Pyk33/od-11-minimix/scratch/u7_crop.png

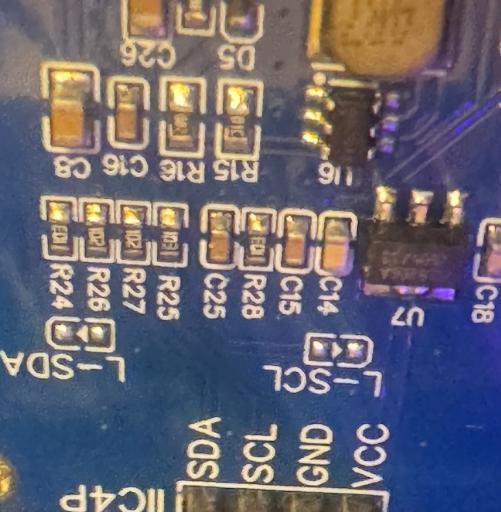
scratch/u7_crop.png
