Pyk33/od-11-minimix/scratch/oled_board_crop.png

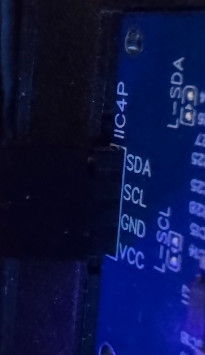
scratch/oled_board_crop.png
