Pyk33/od-11-minimix/scratch/all_columns_top.png

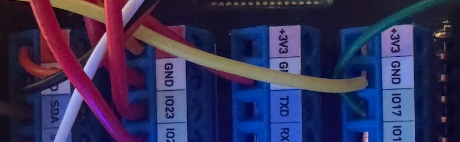
scratch/all_columns_top.png
