Pyk33/od-11-minimix/scratch/gpio_leds_hi.png

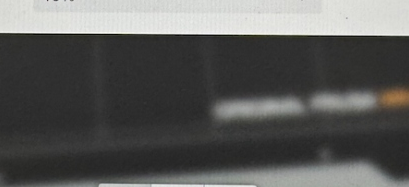
scratch/gpio_leds_hi.png
