Pyk33/od-11-minimix/scratch/mc01506_pdf.png

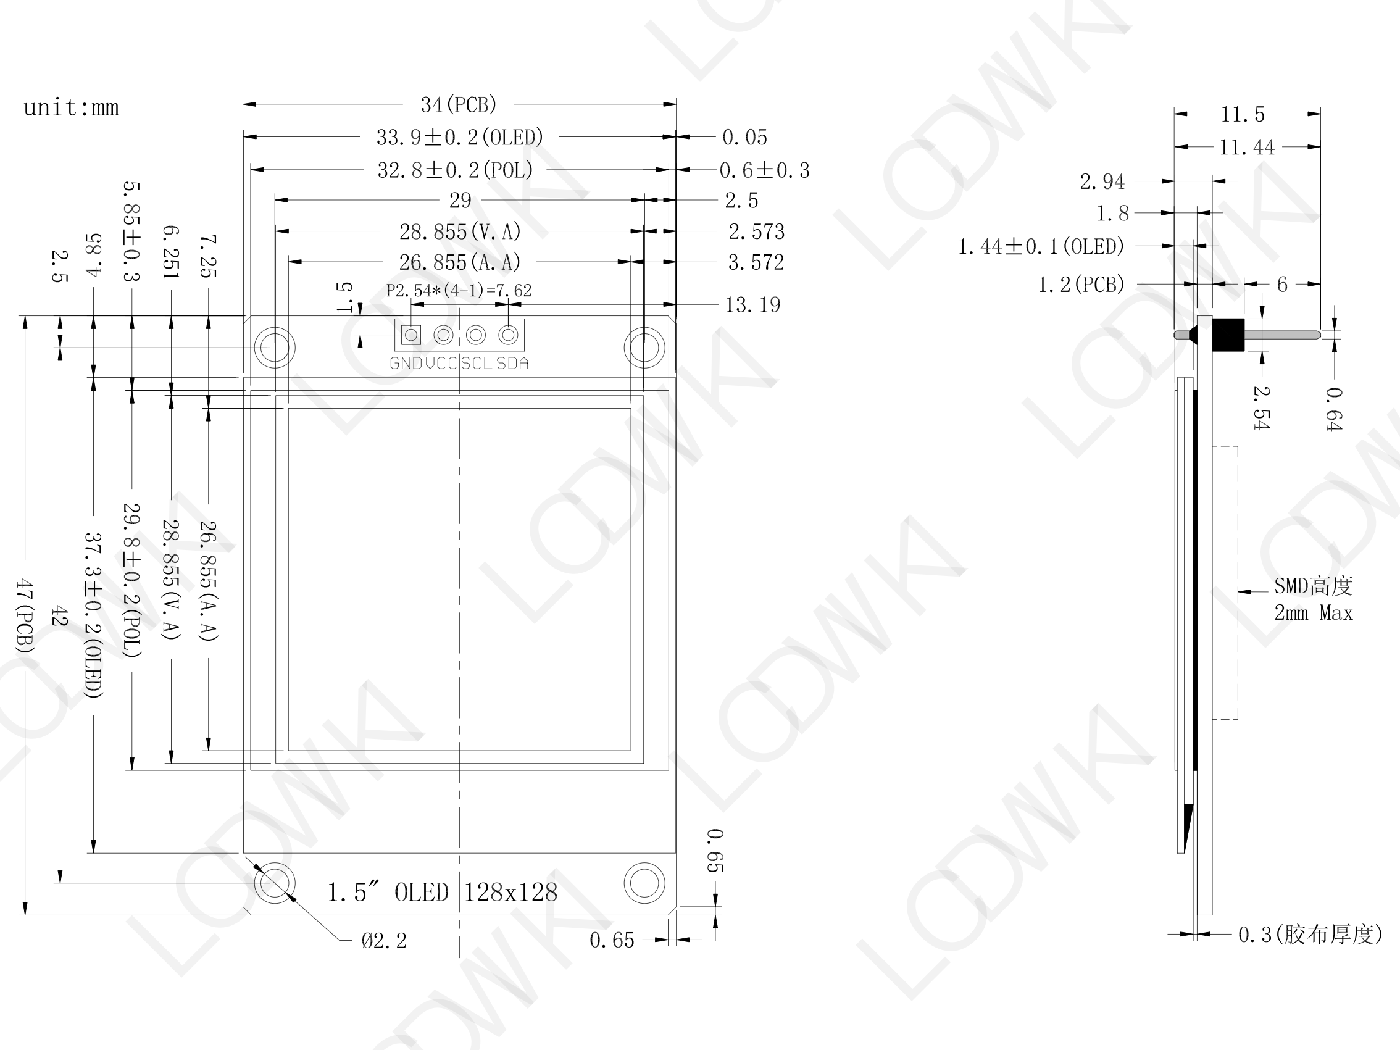
scratch/mc01506_pdf.png
