Pyk33/od-11-minimix/scratch/mc01506_size.png

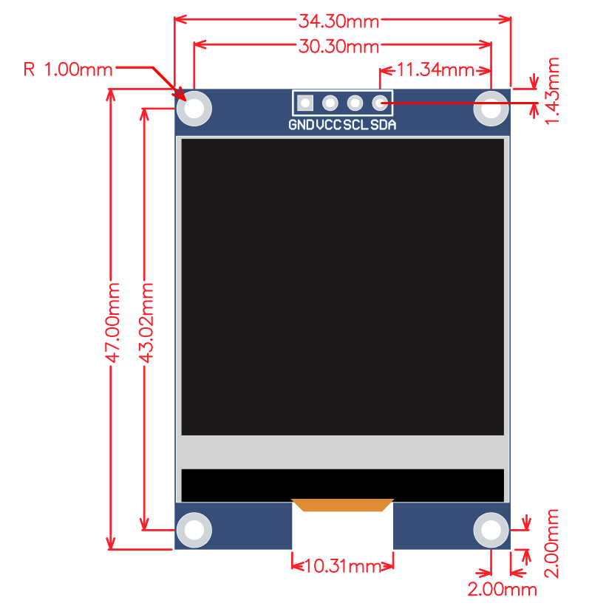
scratch/mc01506_size.png
