Pyk33/od-11-minimix/scratch/preview_128x128_main.png

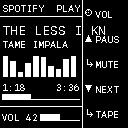
scratch/preview_128x128_main.png
