Pyk33/od-11-minimix/scratch/preview_128x128_tape.png

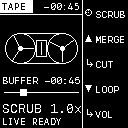
scratch/preview_128x128_tape.png
