Pyk33/od-11-minimix/cad_output/od11_minimix_assembly_with_components.step

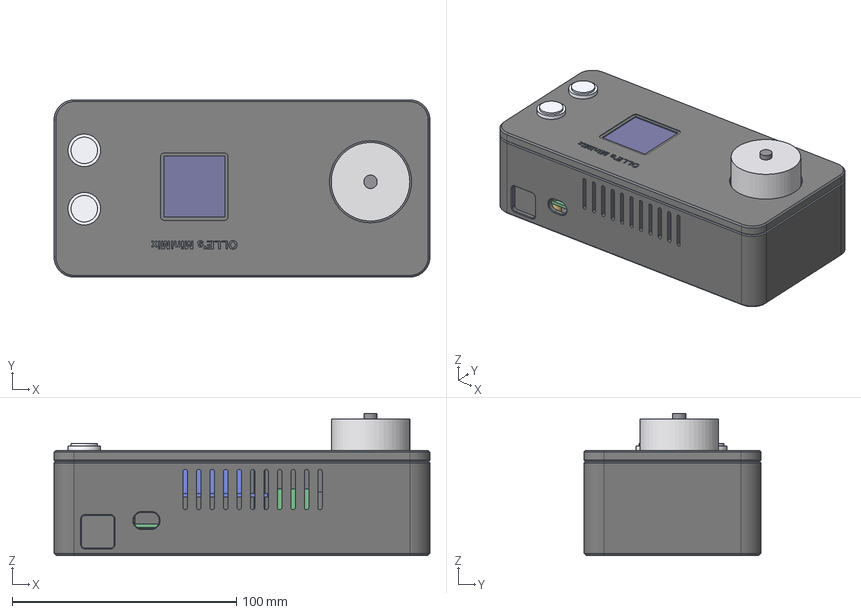
[picture p10: CAD file, 2026-10-18]
cad_output/od11_minimix_assembly_with_components.step
167.5 x 79.0 x 63.3 mm
Botten
Lock
Pi_PCB
Pi_USB_Eth
HAT_PCB
HAT_plintar
Distans1_nedre
Distans1_mitt
Distans1_ovre
Pinne1
Distans2_nedre
Distans2_mitt
Distans2_ovre
Pinne2
Distans3_nedre
Distans3_mitt
Distans3_ovre
Pinne3
Distans4_nedre
Distans4_mitt
Distans4_ovre
Pinne4
Cubilux_TOSLINK
Cubilux_kabel
Cubilux_USB_ANTAGET
Knapp1_kropp
Knapp1_mutter
Knapp1_huvud
Knapp2_kropp
Knapp2_mutter
Knapp2_huvud
Encoder_kropp
Encoder_krage
Encoder_axel
Ratt
OLED_PCB
OLED_glas
OLED_lodspets
OLED_pinhus
