Pyk33/od-11-minimix/cad_output/od11_minimix_assembly.step

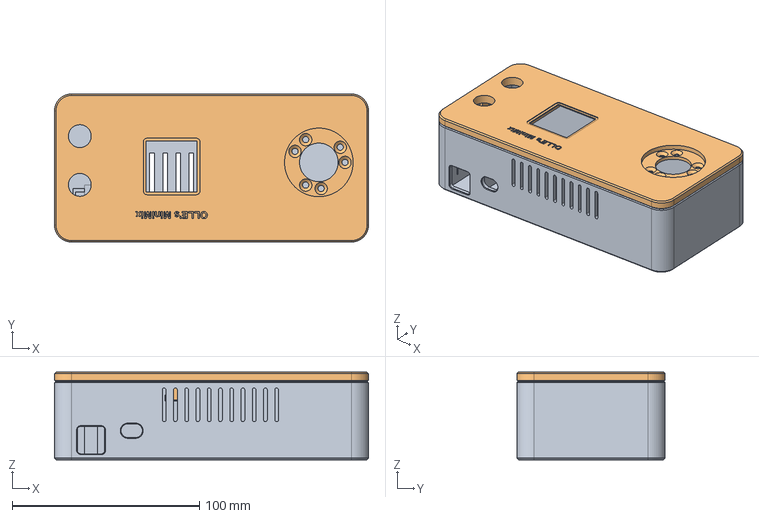
[picture p11: CAD file, 2026-10-18]
cad_output/od11_minimix_assembly.step
167.5 x 79.0 x 46.9 mm
