Pyk33/od-11-minimix/cad_output/od11_minimix_lid.step

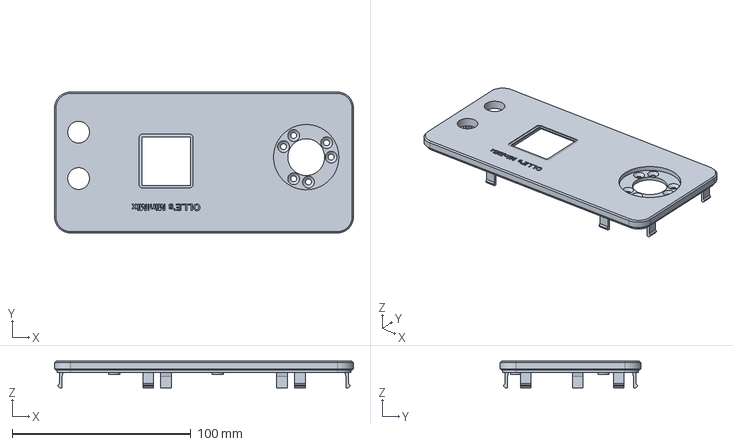
[picture p12: CAD file, 2026-10-18]
cad_output/od11_minimix_lid.step
167.5 x 79.0 x 15.0 mm
