Pyk33/od-11-minimix/cad_output/od11_minimix_base.step

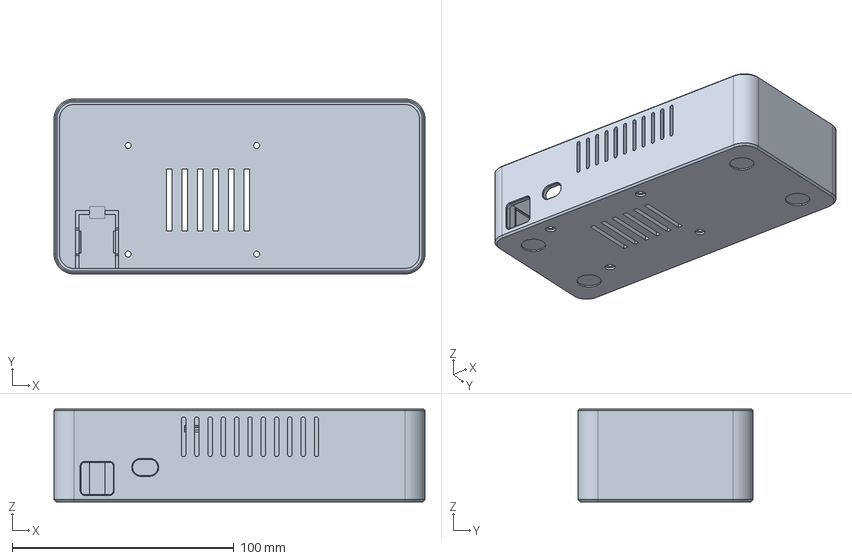
[picture p13: CAD file, 2026-10-18]
cad_output/od11_minimix_base.step
167.5 x 79.0 x 41.9 mm
