Pyk33/od-11-minimix/(list of files, cad)

Other CAD files:
cad_output/od11_minimix_base.stl
cad_output/od11_minimix_lid.stl
