Pyk33/od-11-minimix/manual.html

OLLE'S MINI-MIX OD-11 AUDIO COMPANION

ANVÄNDARMANUAL • USER GUIDE

# Snabbguide & Funktioner

Olle's Mini-Mix är en taktil hårdvarukontroll och ljudstreamer för din Teenage Engineering OD-11. Utrustad med kontinuerlig 15-minuters bandbuffert i minnet, realtidsspolning, och instant looper med framåtriktad expansion och sömlös uppspelningskontinuitet.

Hårdvara

## De fysiska reglagen

⟳

Ratten (Encoder)

Optisk steglös ratt med precision. Styr Master-volym i normalläge, spolar och scratchar i bandet i TAPE-läge, och styr looplängd (SIZE) samt loopens position (MOVE) i LOOP-läge.

▶ ⏸

Övre knapp (Play/Pause)

Växlar Play / Pause i normalläge. I TAPE-läge hoppar den direkt till LIVE med 1-klick DJ Merge. I LOOP-läge växlar den ratten mellan SIZE och MOVE (SWAP).

⏭ ⚙

Nedre knapp (Next/Mode)

Hoppar till nästa låt i normalläge. Hålls den intryckt (>0,5 sek) växlar du in och ut ur de kreativa lägena (TAPE & LOOP).

OLED

1.3" OLED & Trafikljusikon

Visar låt, framsteg, volym och rullbandshjul. I nedre högra hörnet visas en vertikal 2-knappskapsel (trafikljus): den fyllda pricken visar vilken knapp (övre/nedre) som avses. Kort klick visar direkt funktionen (t.ex. LIVE, SWAP); långt tryck visas med prefixet HOLD:.

Hur du växlar lägen:

1. VOL (Normalläge) ──(Håll Next >0,5s)──▶ 2. TAPE (Magic Tape) ◀──(Klicka)──▶ 3. LOOP (Looper) ◀──(Klicka)──▶ 4. DJ (Filter & Brake)

💡 Tips: Håll in Next i >0,5 sekunder från vilket läge som helst för att omedelbart återgå till standardläget (VOL). Musiken fortsätter alltid spela sömlöst framåt från exakt den punkt nålen befinner sig på!

LÄGE 1

### VOL — Live & Volymkontroll

VOL

Detta är standardläget när du lyssnar på musik. Ljudet strömmas i realtid från Spotify eller AirPlay direkt till din OD-11 med bit-perfect 48 kHz digital ljudkvalitet.

Reglage | Handling | Vad som händer
Ratten | Vrid medurs / moturs | Höjer / sänker volymen En stor volymsiffra visas på skärmen (0–85 %). Synkas i realtid med Spotify/telefonen.
Övre knapp | Kort tryck | Play / Pause
Övre knapp | Håll intryckt (0,7 s) | Mute / Unmute (tystar ljudet direkt)
Nedre knapp | Kort tryck | Nästa låt
Nedre knapp | Håll intryckt (0,7 s) | Växla till TAPE-läget!

LÄGE 2

### TAPE — OB-4 Magic Tape (Spolning, Scratch & LIVE)

TAPE

En kontinuerlig 15-minuters bandbuffert spelar in all musik i minnet. Ratten fungerar precis som handen på en vinylskiva med slipmat: 1:1 direkt kontakt med spåret! När du snurrar bakåt spelas musiken baklänges i handens hastighet; när du snurrar framåt spolas musiken framåt med dynamisk hastighetsacceleration så du når LIVE t-0 med ett snabbt knyck. När den når nutid spärras den bergfast vid LIVE. När du släpper ratten fortsätter musiken spela sömlöst från aktuell punkt utan att hoppa!

Reglage | Handling | Vad som händer
Ratten | Vrid moturs | Vinyl Scratch bakåt! 1:1 taktilitet som en vinylskiva. Musiken rör sig bakåt i spåret exakt i takt med din hand.
Ratten | Vrid medurs | Super Spool framåt mot LIVE! Progressiv hastighetsacceleration: snabba knyck sveper 30–60 sekunder på nolltid. Spärras och fastnar bergfast vid LIVE (t-0).
Övre knapp | Kort tryck | 1-KLICK DJ MERGE TO LIVE! Mjuk equal-power DJ-crossfade som stilrent mixar bandet in i realtidsströmmen utan skarpa avbrott! Vid LIVE: Vanlig Play/Pause (visar PAUSED).
Övre knapp | Håll intryckt (>0,5 s) | DIREKT KLIPP TILL LIVE! Omedelbart snitt direkt till realtidsmusiken utan fade.
Nedre knapp | Kort tryck | Växla till LOOP-läget
Nedre knapp | Håll intryckt (>0,5 s) | Återgå till VOL-läget Musiken fortsätter spela sömlöst framåt från aktuell punkt!

LÄGE 3

### LOOP — Instant Looper (Framåt-expansion & Glidande Fönster)

LOOP

Fångar omedelbart en slinga av musiken och upprepar den rytmiskt med klickfria crossfades. När du ökar looptiden läggs tiden till framåt i låten så att kommande takter kommer in i loopen! Du kan även växla ratten till MOVE för att flytta hela loopfönstret fram och tillbaka längs låtens tidslinje.

Reglage | Handling | Vad som händer
Övre knapp | Kort tryck | Växla rattläge mellan SIZE och MOVE (SWAP)! Toppraden visar [SIZE] MOVE eller SIZE [MOVE]. Under loopen visas LEN: och låtens tidslinje med loopen som en interaktiv box [ ■ ].
Ratten (i SIZE) | Vrid medurs / moturs | Ändra looplängd (FRAMÅT) Starten förblir förankrad och extra tid läggs till framåt i låten! Stegar mellan 0,125 s upp till 16 s.
Ratten (i MOVE) | Vrid medurs / moturs | Flytta loopen längs tidslinjen Skjuter hela loopfönstret framåt eller bakåt så du hittar exakt rätt parti att loopa.
Övre knapp | Håll intryckt (>0,5 s) | Reverse Loop (spelar loopen baklänges!)
Nedre knapp | Kort tryck | Växla till DJ-läget
Nedre knapp | Håll intryckt (>0,5 s) | Återgå till VOL-läget Musiken fortsätter spela sömlöst framåt från loopen in i resten av låten!

LÄGE 4

### DJ — Color Filter & Turntable Tape Brake

DJ

Ett kraftfullt DJ-verktyg för fest och häng. Vrid ratten för att svepa ett analogt resonant filter (LPF eller HPF), snäpp tillbaka med ett klick för episka beat drops, eller håll knappen för äkta skivbroms (Tape Stop)!

Reglage | Handling | Vad som händer
Ratten (Vrid moturs) | Vrid moturs | Low-Pass Filter (LPF) Skär bort diskant och sång. Ljudet blir dovt och djupt som om du står i toakön utanför klubben!
Ratten (Vrid medurs) | Vrid medurs | High-Pass Filter (HPF) Skär bort bas och kick — bygger upp enorm förväntan inför beat droppet!
Övre knapp | Kort tryck | BEAT-MATCHED TRANSITION (XFADE) Intelligent DJ-övergång! Håller förra låtens groove vid 100 % volym tills nästa låt faktiskt levererar ljud. Matchar taktslag och energinivå, droppar in på takten och sveper med filter. Noll tystnad, noll volymdipp, 100 % musikaliskt! Klicka igen för att avbryta/snäppa till nutid.
Övre knapp | Håll intryckt (>0,5 s) | TURNTABLE BRAKE (Tape Stop) Stänger av motorn! Musiken saktar in och stannar som en vinylspelare (wwwhhhoooom...). Släpp för att varva upp igen!
Nedre knapp | Kort tryck | Växla tillbaka till TAPE-läget
Nedre knapp | Håll intryckt (>0,5 s) | Återgå till VOL-läget

📱 Spela från mobilen

Spotify: Öppna Spotify och välj "Olle's Mini-Mix" i enhetslistan.

AirPlay: Välj "Olle's Mini-Mix" i AirPlay-menyn på din iPhone/iPad/Mac. Volymen i telefonen och på ratten synkas automatiskt.

🌙 Automatisk skärmsläckare

När musiken är pausad och ingen rört enheten på 5 minuter släcks skärmen automatiskt för att skydda OLED-panelen.

Den vaknar direkt så fort du rör ratten, klickar på en knapp eller startar musik från mobilen.

⏻

#### Säker avstängning av strömmen

Håll båda knapparna samtidigt i 3 sekunder.
Skärmen visar SHUTTING DOWN... och enheten stängs av kontrollerat och säkert. När dioderna slocknat kan sladden tryggt dras ur.

OLLE'S MINI-MIX • TEENAGE ENGINEERING OB-4 & OD-11 COMPANION

Minimalistisk taktil streamer och bandminne
