Pyk33/od-11-minimix/scratch/mc01506_size.pdf

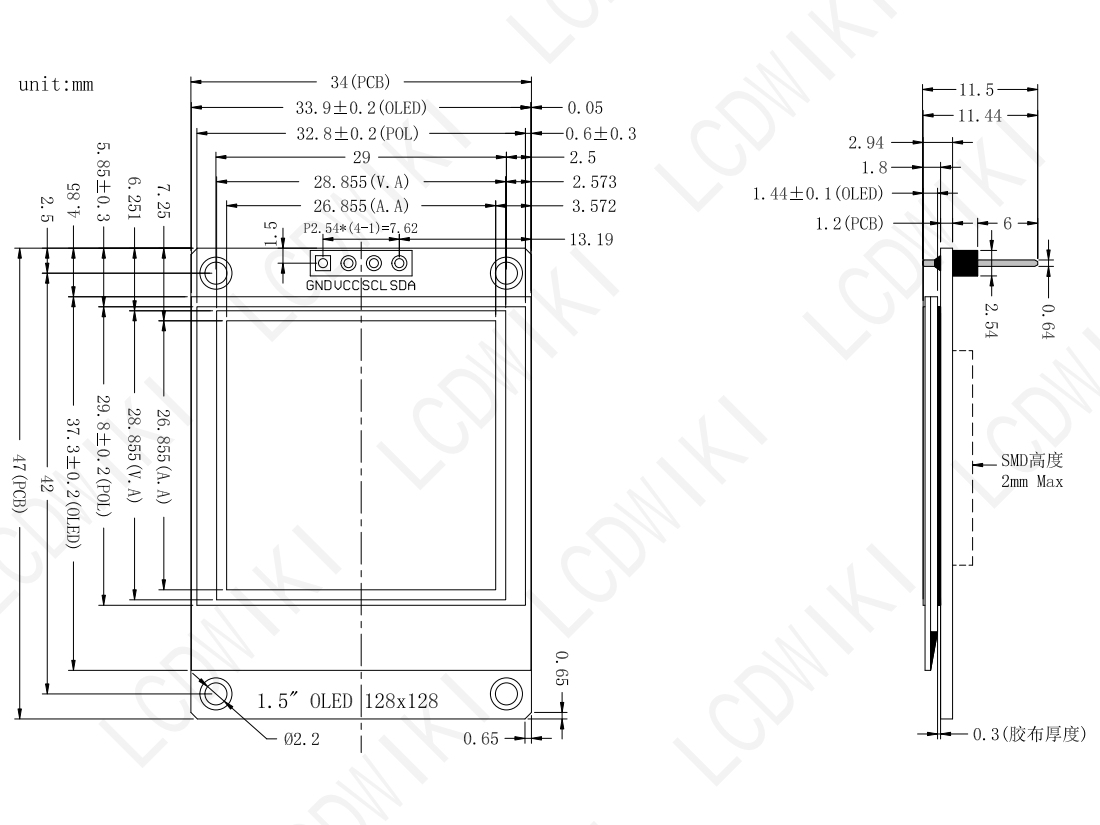
[picture p14: page 1]

LCDWIKI LCDWIKI LCDWIKI
