Pyk33/od-11-minimix/(commit log)

2026-10-10 Restore ALSA dmix sample rate to 48000
2026-10-10 Update WIRING.md with user-selected wire colors for OLED
2026-10-10 Update wiring.svg with OLED wire colors
2026-10-10 Invert encoder direction, smooth sensitivity, and set standby title to OLLE'S MINIMIX
    [streamer.py]
2026-10-11 fix: rätta variabelnamn i ambient view och hantera knappstängning i combo_watcher
    [streamer.py]
2026-10-11 fix(audio): smooth inertial tape scrub, calibrated loop detent, and phase-locked loop animation
    [streamer.py, tape_engine.py]
2026-10-11 feat: 1:1 vinyl slipmat scratch engine and seamless playback continuity
    [streamer.py, tape_engine.py]
2026-10-11 fix: eliminate circular buffer wrap when scrubbing forward to live; add bounded live lock and HOLD 1:LIVE hint
    [streamer.py, tape_engine.py]
2026-10-12 Remove confusing STOPPED tape brake; use standard Play/Pause and DJ Merge to LIVE
2026-10-12 Replace BTN1/2 with 2-dot capsule traffic light icon and HOLD prefix
    [streamer.py]
2026-10-12 Implement 1cm context control sidebar on right and fix LIVE audio flimmer with smooth PLL
    [streamer.py, tape_engine.py]
2026-10-12 Update sidebar glyphs to distinct arrows (▲/▼) and branch (↳) for held actions
2026-10-12 Refactor LOOP UX: show SIZE/MOVE in header, length and track position under loop
2026-10-12 Increase wheel sensitivity in TAPE and LOOP for large rotor wheels
2026-10-12 Add DJ mode: resonant bi-polar filter and turntable tape brake
2026-10-12 Fix DJ mode: fix encoder step trapping at zero, add button release callback for brake
    [streamer.py, tape_engine.py]
2026-10-12 Calibrate DJ wheel sensitivity for large rotor (~500 steps for full sweep)
2026-10-12 Fix delay jitter: apply exponential smoothing and rounding to delay time, cleanup loop_active state
    [streamer.py, tape_engine.py]
2026-10-12 Fix DJ mode: eliminate deadband trapping, ensure continuous responsive sweep from step 1
    [dsp_filter.c, tape_engine.py]
2026-10-12 Fix DJ crossfade: eliminate backward jump, play forward continuously with LPF and stereo space echo tail
    [streamer.py, tape_engine.py]
2026-10-12 DJ mode: fade into new song 10 seconds in to skip silent intro
    [streamer.py, tape_engine.py]
2026-10-12 TAPE mode: clamp pitch to musical 2.0x, add anti-squeal damping filter, make DJ Merge vs CUT crystal clear audibly and visually
2026-10-12 feat(dj): incorporate and preserve user LPF/HPF filter position in Xfade
2026-10-12 fix(dj): fix _SVFState array access for seamless transition filter copy
    [tape_engine.py]
2026-10-12 feat(loop): long press triggers XFADE from active loop into next track
2026-10-12 fix(xfade): eliminate buzz during xfade with monotonic PLL playhead and smooth crossover
    [tape_engine.py]
2026-10-12 feat(loop): make loop standby upon entering mode, activate on wheel turn or mode toggle
2026-10-12 fix(loop): define live_edge before calculating anchor in set_mode
    [tape_engine.py]
2026-10-15 Add parametric CAD models, STL/STEP exports, and verification scripts for enclosure
    [od11_minimix_assembly.step, od11_minimix_assembly_with_components.step, od11_minimix_base.step, od11_minimix_base.stl, od11_minimix_lid.step, od11_minimix_lid.stl]
2026-10-16 Rotate OLED 180° in software and swap Play/Pause (IO23) and Next (IO22) for new orientation
    [streamer.py]
2026-10-16 Move ventilation to cable wall and add vent audit checks
    [od11_minimix_assembly.step, od11_minimix_assembly_with_components.step, od11_minimix_base.step, od11_minimix_base.stl, od11_minimix_lid.step]
2026-10-16 Rev 3 CAD: larger 9mm corner radius, shadow gap & chamfers, stadium vents, screwless snap lid, OLLE's MiniMix engraving, and Cubilux pull-out retention
    [od11_minimix_assembly.step, od11_minimix_assembly_with_components.step, od11_minimix_base.step, od11_minimix_base.stl, od11_minimix_lid.step, od11_minimix_lid.stl]
2026-10-16 cad(rev4): sänk rotorn med nedsänkt rattbrunn och M3x6 försänkning
    [od11_minimix_assembly.step, od11_minimix_assembly_with_components.step, od11_minimix_base.step, od11_minimix_lid.step, od11_minimix_lid.stl]
2026-10-18 feat(hardware): upgrade lid CAD and software for 1.5 inch square SH1107 OLED
    [od11_minimix_assembly.step, od11_minimix_assembly_with_components.step, od11_minimix_base.step, od11_minimix_lid.step, od11_minimix_lid.stl]
2026-10-18 docs(wiring): update wiring diagram and documentation for 1.5 inch OLED with 5V supply
2026-10-18 docs(wiring): maintain orange wire color for VCC in diagram
2026-10-18 docs(wiring): update pin table row for 5V OLED VCC
2026-10-18 Reinforce lid snap hooks with tapered root, 1.6mm beam, 8mm width and 0.6mm lip
    [od11_minimix_assembly.step, od11_minimix_assembly_with_components.step, od11_minimix_base.step, od11_minimix_base.stl, od11_minimix_lid.step, od11_minimix_lid.stl]
2026-10-18 Keep base 100% identical to printed base; reinforce lid snap hooks inwards
    [od11_minimix_assembly.step, od11_minimix_assembly_with_components.step, od11_minimix_base.step, od11_minimix_base.stl, od11_minimix_lid.step, od11_minimix_lid.stl]
2026-10-18 docs(cad): document reinforced snap hooks and printed base compatibility
2026-10-19 feat(display): implement robust SH1107 bitbang driver and update wiring for 1.5 inch OLED
2026-10-20 fix(audio): eliminate xfade and tape scrubbing glitches by restoring C libdsp and continuous tape physics
    [libsh1107.c, sh1107_driver.py, streamer.py, tape_engine.py]
2026-10-24 feat: add scratch files for OLED bitbang testing and Raspberry Pi automation
2026-10-24 feat(games): implement Music Quiz, Reverse Detective, and Safe Cracker minigames
    [streamer.py]
2026-10-24 feat(ui): redesign interface to 128px widescreen with Teenage Engineering bottom control bar
    [streamer.py]
2026-10-24 feat(ui): add 2-tier dock showing both short-press tap and long-press hold actions
    [streamer.py]
